electrician-faceit9/Dual-Sensor-High-G-Impact-Meter-and-Threshold-Based-Early-Warning-System-for-Combat-Sports/Malzeme_Blok_Semasi.pdf

## Giyilebilir Darbe Ölçer: Malzeme Blok Şeması

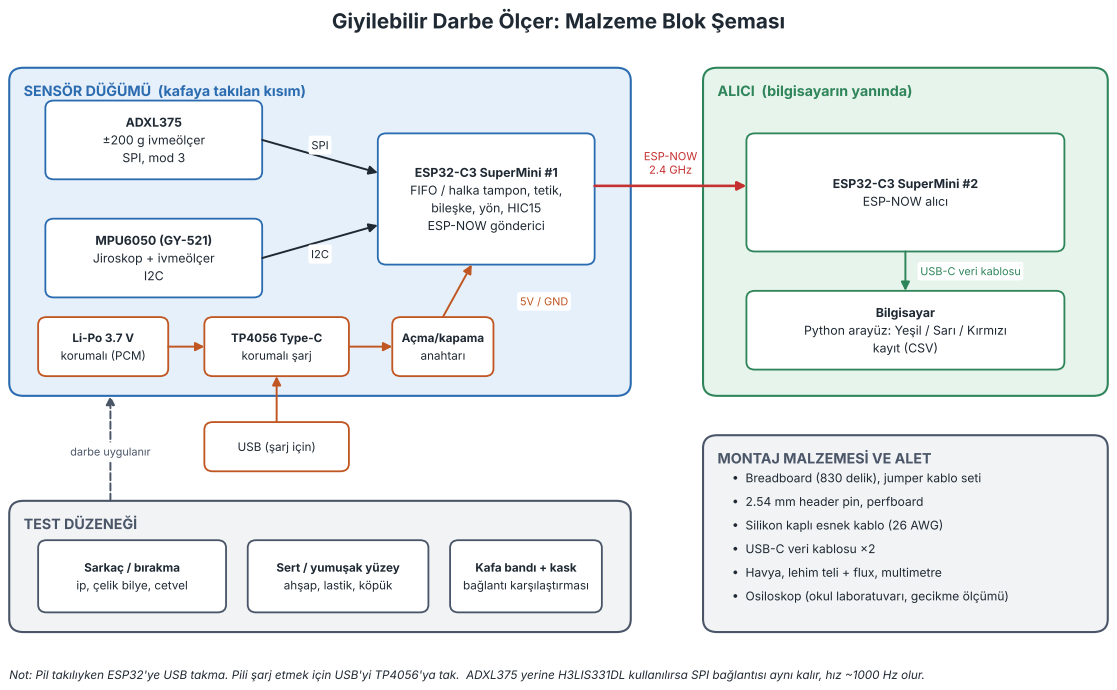
[picture p3: page 1]
ADXL375; ±200 g ivmeölçer; SPI, mod 3; MPU6050 (GY-521); Jiroskop + ivmeölçer; SPI; korumalı (PCM); TP4056 Type-C; korumalı şarj; Açma/kapama anahtarı; 5V / GND; Bilgisayar; kayıt (CSV); ESP-NOW 2.4 GHz; TEST DÜZENEĞİ; Sarkaç / bırakma; darbe uygulanır; MONTAJ MALZEMESİ VE ALET

SENSÖR DÜĞÜMÜ (kafaya takılan kısım)

ALICI (bilgisayarın yanında)

ESP32-C3 SuperMini #1
FIFO / halka tampon, tetik,
bileşke, yön, HIC15
ESP-NOW gönderici

ESP32-C3 SuperMini #2
ESP-NOW alıcı

USB-C veri kablosu

Python arayüz: Yeşil / Sarı / Kırmızı

USB (şarj için)

• Breadboard (830 delik), jumper kablo seti

• 2.54 mm header pin, perfboard

• Silikon kaplı esnek kablo (26 AWG)

• USB-C veri kablosu ×2

Sert / yumuşak yüzey
ahşap, lastik, köpük

Kafa bandı + kask
bağlantı karşılaştırması

• Havya, lehim teli + flux, multimetre

ip, çelik bilye, cetvel

• Osiloskop (okul laboratuvarı, gecikme ölçümü)

Not: Pil takılıyken ESP32'ye USB takma. Pili şarj etmek için USB'yi TP4056'ya tak. ADXL375 yerine H3LIS331DL kullanılırsa SPI bağlantısı aynı kalır, hız ~1000 Hz olur.
